Mazda-F/391Robot/README.md

# ELEC 391 Course Project: Cascaded PID Control of a Two-Wheel Inverted Pendulum Robot

Submission Date: April 13, 2025 \
Mazda Farrahi, Qinnan Zhou &copy; 2025

**DISCLAIMER: As per UBC's Academic Honesty and Integrity policy, any usage of the code and/or resources within this public repository must be referenced by students. A violation of the aforementioned policy may result in charges of academic misconduct.**

## Quick Links:
**[BOM LIST](#bom-list)**

**[YOUTUBE LINK: VIDEO DEMO](https://www.youtube.com/watch?v=I9QuAMcz9hc)** 

**[PROJECT REPORT PDF](/Final_Report.pdf)** 

---

**INFO:** This project is for ELEC 391, the project course for third-year Electrical Engineering at UBC. This repository includes all the code written for this project, including MATLAB simulation code and Simulink files for the controls portion. 

The overall repository includes:
  - [Directory] [ESP32 Camera Access Point](/camera/)
  - [Directory] [MATLAB & Simulink Controls](/controls/)
  - [Directory] [Python GUI](/gui/)
  - [File] [Main Robot Code](/robot.ino)

## GUI
To launch the GUI, run [`dashboard.py`](/gui/dashboard.py) 

Required Python Packages:
- `cv2`
- `numpy`
- `PIL`
- `customtkinter`
- `tkinter`
- `pyserial`
- `bleak`
- `pyo`

## BOM List
| Item | Price / Item | URL |
| :--- | ---: | ----: |
| ESP32-CAM | $22.90 | [Link](https://www.amazon.ca/CANADUINO-ESP32-CAM-ESP32-CAM-MB-Programming-Adapter/dp/B08XYLSH15/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) |
| MG90S 9G Servo | $3.60  | [Link](https://www.amazon.ca/Miuzei-MG90S-Servo-Helicopter-Arduino/dp/B0BWJ26PX2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) |
| (2x) DC-DC Buck Boost Voltage Converter |  $3.20  | [Link](https://www.amazon.ca/XLX-XL6009-DC-DC-Converter-Power-Adjustable-Step-Down/dp/B08PP1N8G5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) |
| MPU-6050 MPU6050 Sensor |  $5.33 | [Link](https://www.amazon.ca/Wishiot-MPU-6050-Accelerometer-Gyroscope-Converter/dp/B0C3LG1Y6W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) |
| ELEGOO UNO R3 Board ATmega328P |  $21.99  | [Link](https://www.amazon.ca/Elegoo-Board-ATmega328P-ATMEGA16U2-Arduino/dp/B01EWOE0UU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) |
| **TOTAL** | **$60.22**| |
