Mazda-F/391Robot/camera/camera_index.h

#define index_html_gz_len 3635
const uint8_t index_html_gz[] = {
 0x1F, 0x8B, 0x08, 0x08, 0x8A, 0xF8, 0xFE, 0x5B, 0x00, 0x03, 0x69, 0x6E, 0x64, 0x65, 0x78, 0x2E,
 0x68, 0x74, 0x6D, 0x6C, 0x00, 0xDD, 0x5C, 0xFD, 0x72, 0xDA, 0xB8, 0x16, 0xFF, 0x7F, 0x9F, 0xC2,
 0x71, 0x77, 0x8B, 0x3D, 0x6B, 0x08, 0x10, 0x92, 0xA6, 0x26, 0x90, 0x0D, 0x84, 0xB6, 0x3B, 0xD3,
 0xAF, 0x6D, 0xF6, 0xEE, 0xEE, 0xCC, 0xCE, 0x4E, 0x2B, 0x6C, 0x19, 0xD4, 0x18, 0x8B, 0xDA, 0x72,
 0x80, 0xB2, 0x7E, 0x8E, 0xFB, 0x40, 0xF7, 0xC5, 0xEE, 0x91, 0x64, 0x1B, 0x9B, 0x8F, 0x10, 0xA0,
 0x85, 0x4E, 0x9B, 0x19, 0x90, 0xE5, 0xA3, 0xA3, 0x73, 0xCE, 0xEF, 0x7C, 0x48, 0xC6, 0xEA, 0xC5,
 0x91, 0x4D, 0x2D, 0x36, 0x19, 0x62, 0xA5, 0xCF, 0x06, 0x6E, 0xF3, 0x87, 0x0B, 0xF9, 0xA5, 0xC0,
 0xBF, 0x8B, 0x3E, 0x46, 0xB6, 0x6C, 0x8A, 0xCB, 0x01, 0x66, 0x48, 0xB1, 0xFA, 0xC8, 0x0F, 0x30,
 0x6B, 0xA8, 0x21, 0x73, 0x8A, 0xE7, 0xEA, 0xFC, 0x6D, 0x0F, 0x0D, 0x70, 0x43, 0xBD, 0x23, 0x78,
 0x34, 0xA4, 0x3E, 0x53, 0x15, 0x8B, 0x7A, 0x0C, 0x7B, 0x40, 0x3E, 0x22, 0x36, 0xEB, 0x37, 0x6C,
 0x7C, 0x47, 0x2C, 0x5C, 0x14, 0x17, 0x06, 0xF1, 0x08, 0x23, 0xC8, 0x2D, 0x06, 0x16, 0x72, 0x71,
 0xA3, 0x92, 0xE5, 0xC5, 0x08, 0x73, 0x71, 0xB3, 0x73, 0xF3, 0xF6, 0xA4, 0xAA, 0xBC, 0xF9, 0xA3,
 0x5A, 0x3B, 0x2B, 0x5F, 0x1C, 0xCB, 0xBE, 0x19, 0x4D, 0xC0, 0x26, 0xFC, 0xBA, 0x4B, 0xED, 0xC9,
 0xD4, 0x81, 0x69, 0x8A, 0x0E, 0x1A, 0x10, 0x77, 0x62, 0x5E, 0xF9, 0xC0, 0xD4, 0x78, 0x81, 0xDD,
 0x3B, 0xCC, 0x88, 0x85, 0x8C, 0x00, 0x79, 0x41, 0x31, 0xC0, 0x3E, 0x71, 0xEA, 0x5D, 0x64, 0xDD,
 0xF6, 0x7C, 0x1A, 0x7A, 0xB6, 0xF9, 0xA8, 0x72, 0xCE, 0xFF, 0xEA, 0x16, 0x75, 0xA9, 0x6F, 0x3E,
 0xEA, 0x3C, 0xE3, 0x7F, 0x75, 0xC1, 0x27, 0x20, 0x9F, 0xB1, 0x59, 0x39, 0x1B, 0x8E, 0xA3, 0x7E,
 0x75, 0x9A, 0xE9, 0x39, 0x87, 0x9E, 0x00, 0x5B, 0x8C, 0x50, 0xAF, 0x34, 0x40, 0xC4, 0x9B, 0xDA,
 0x24, 0x18, 0xBA, 0x68, 0x62, 0x3A, 0x2E, 0x1E, 0x47, 0x8F, 0x06, 0xD8, 0x0B, 0x8D, 0xDC, 0x7D,
 0xDE, 0x5F, 0xB4, 0x89, 0x2F, 0xFB, 0x4C, 0x98, 0x2A, 0x1C, 0x78, 0x92, 0x30, 0x1D, 0xEB, 0x51,
 0x0F, 0xD7, 0x05, 0xE1, 0xC8, 0x47, 0x43, 0xB8, 0xE4, 0x5F, 0xF5, 0x01, 0xF1, 0xA4, 0x91, 0xCC,
 0x93, 0x5A, 0x79, 0x38, 0xCE, 0x09, 0x7E, 0x72, 0xC6, 0xFF, 0xEA, 0x43, 0x64, 0xDB, 0xC4, 0xEB,
 0x99, 0xE7, 0xFC, 0x36, 0xF5, 0x6D, 0xEC, 0x17, 0x7D, 0x64, 0x93, 0x30, 0x30, 0x6B, 0xD0, 0x33,
 0x40, 0x7E, 0x0F, 0x78, 0x30, 0x3A, 0x34, 0x8B, 0x95, 0xF2, 0xAC, 0xC3, 0x27, 0xBD, 0x3E, 0x33,
 0x79, 0x4F, 0xF4, 0x28, 0xC6, 0x26, 0xA7, 0x46, 0x46, 0x14, 0x21, 0x08, 0x72, 0x49, 0xCF, 0x2B,
 0x12, 0x86, 0x07, 0x81, 0x19, 0x30, 0x1F, 0x33, 0xAB, 0x1F, 0x39, 0xA4, 0x17, 0xFA, 0x78, 0x9A,
 0x08, 0x50, 0x8E, 0x79, 0x43, 0xA3, 0x38, 0xC2, 0xDD, 0x5B, 0xC2, 0x8A, 0xF1, 0x64, 0x5D, 0xEC,
 0x50, 0x1F, 0xA7, 0x04, 0xC5, 0xAE, 0x4B, 0xAD, 0xDB, 0x62, 0xC0, 0x90, 0xCF, 0x16, 0x89, 0x91,
 0xC3, 0xB0, 0x3F, 0x4F, 0x8B, 0x41, 0xE1, 0x05, 0xCA, 0x84, 0x41, 0x7C, 0x49, 0x3C, 0x97, 0x78,
 0x78, 0x15, 0x5B, 0xC9, 0x21, 0x4F, 0x2A, 0xFA, 0x62, 0x35, 0x14, 0x32, 0xE8, 0xA5, 0x16, 0x10,
 0x93, 0xD6, 0xA5, 0xE1, 0x2B, 0xE5, 0xF2, 0x4F, 0xF5, 0x3E, 0x16, 0xF6, 0x42, 0x21, 0xA3, 0xF7,
 0x1B, 0x99, 0xFB, 0xC6, 0x2F, 0x03, 0x6C, 0x13, 0xA4, 0x68, 0x33, 0xF0, 0x94, 0xF3, 0x32, 0x58,
 0x5A, 0x57, 0x90, 0x67, 0x2B, 0x1A, 0xF5, 0x09, 0x58, 0x1B, 0x09, 0x57, 0x70, 0xA1, 0x07, 0xDC,
 0x7E, 0x88, 0xF5, 0xE9, 0x3A, 0x18, 0x62, 0x8F, 0x58, 0x0D, 0xC4, 0x12, 0x0D, 0x06, 0x68, 0x5C,
 0xCC, 0x68, 0xC1, 0x2F, 0x63, 0x4D, 0x20, 0xD4, 0x2C, 0x0D, 0x3A, 0xEF, 0xFA, 0x4A, 0x51, 0xE1,
 0xAE, 0xA5, 0xC7, 0xEA, 0x0A, 0x15, 0x33, 0xEA, 0x7E, 0x2F, 0x28, 0x27, 0x11, 0xFB, 0xA8, 0x1B,
 0x32, 0x46, 0xBD, 0x60, 0x8D, 0x99, 0x3F, 0x86, 0x01, 0x23, 0xCE, 0xA4, 0x18, 0x83, 0x62, 0x06,
 0x43, 0x04, 0xF9, 0xAA, 0x8B, 0xD9, 0x08, 0x63, 0x08, 0x5D, 0x0F, 0xDD, 0x01, 0xDC, 0xBD, 0x9E,
 0x8B, 0xA7, 0x56, 0xE8, 0x07, 0x90, 0x39, 0x86, 0x94, 0x00, 0xA5, 0x5F, 0xCF, 0x01, 0x90, 0x25,
 0x2C, 0x5A, 0xDD, 0x29, 0x0D, 0x19, 0x17, 0x09, 0x44, 0xA4, 0xC0, 0x8F, 0xB0, 0x09, 0xB4, 0xA4,
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
};
