Mazda-F/391Robot/(commit log)

2025-03-02 Initial Encoder code
2025-03-05 Fixed deg -> rad
    [robot.ino]
2025-03-06 Fixed X distance reading from encoders
    [robot.ino]
2025-03-11 Added controls folder
    [TEK00000.CSV, TEK00001.CSV]
2025-03-19 NEW GOOD ONE, needs some angle fixing
    [robot.ino]
2025-03-21 IMU now fast
2025-03-23 Added ESP32 camera initial code
2025-03-24 Fixed pid code
2025-03-28 Fixed reverse encoder logic and bluetooth
    [bluetooth.py, dashboard.py, robot.ino]
2025-03-29 fixed weird connection issue
    [bluetooth.py, dashboard.py, robot.ino]
2025-03-29 All base issues fixed
    [dashboard.py, robot.ino]
2025-04-01 Added steering wheel logic + updates to gui
2025-04-01 Added ability to change filter coefficients for PIDs
2025-04-02 adjusted length of encoder fir
2025-04-07 Fixed external steering wheel speed control
    [dashboard.py]
2025-04-14 Final organization
    [TEK00000.CSV, TEK00001.CSV]
2025-04-14 Added BOM List Hyperlink
